d0ughb0y/Chauvet16/chauvet16_schem.pdf

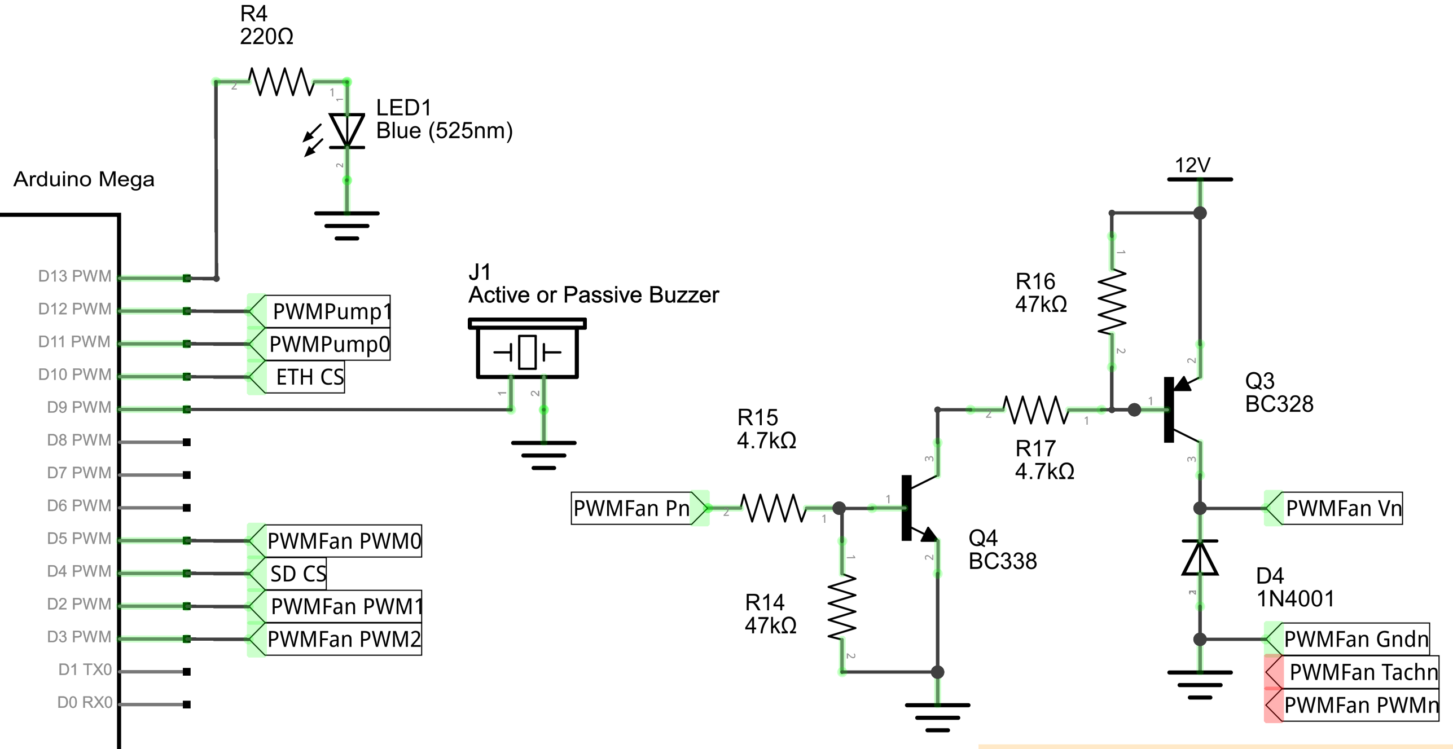
[picture p1: figure]
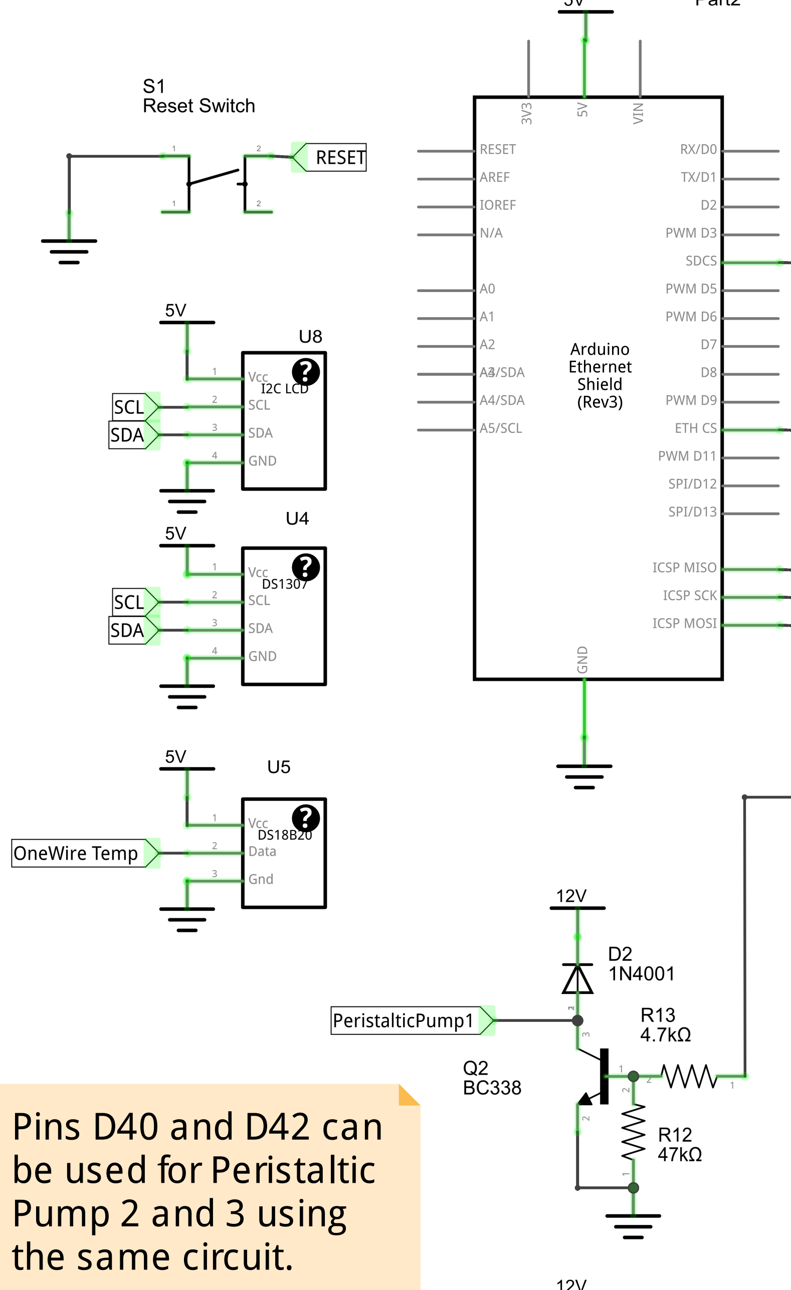
[picture p2: figure]
Pins D40 and D42 can be used for Peristaltic Pump 2 and 3 using the same circuit.

Repeat PWM fan power
drivercircuit for each
additional PWM fan.
PWM 4 pin connector:
Pin1 Gnd, Pin2 V (12v),
Pin3 Tach, Pin4 PWM

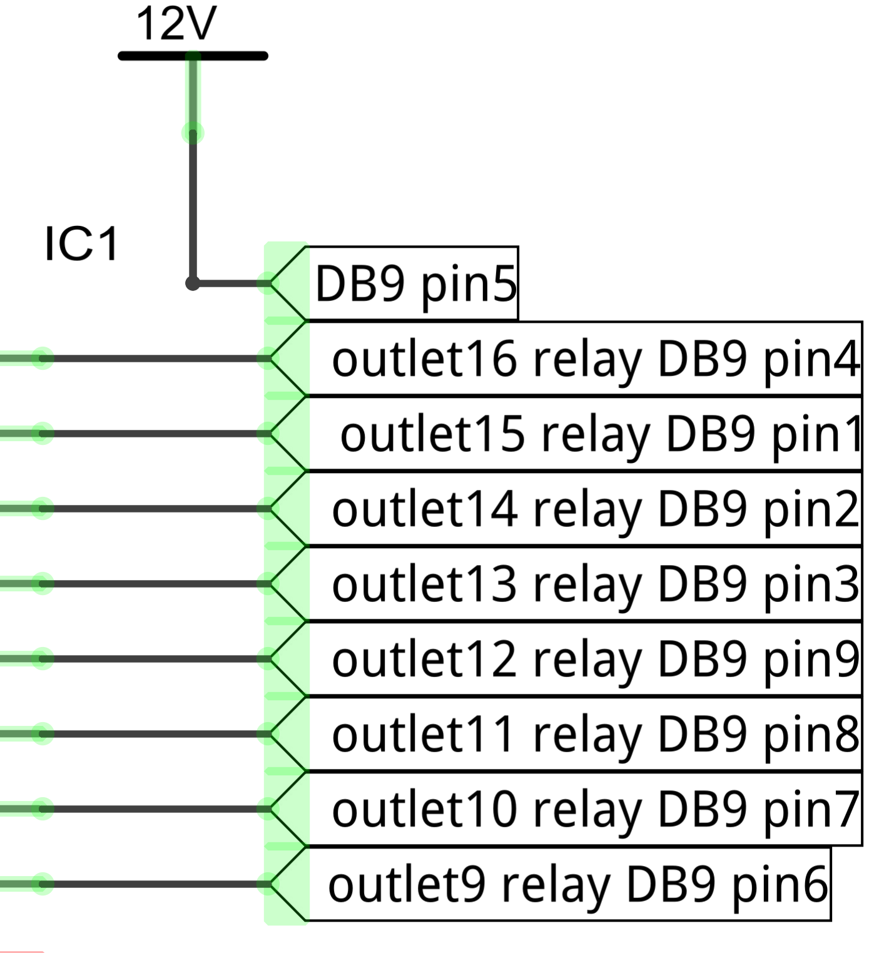
[picture p3: figure]
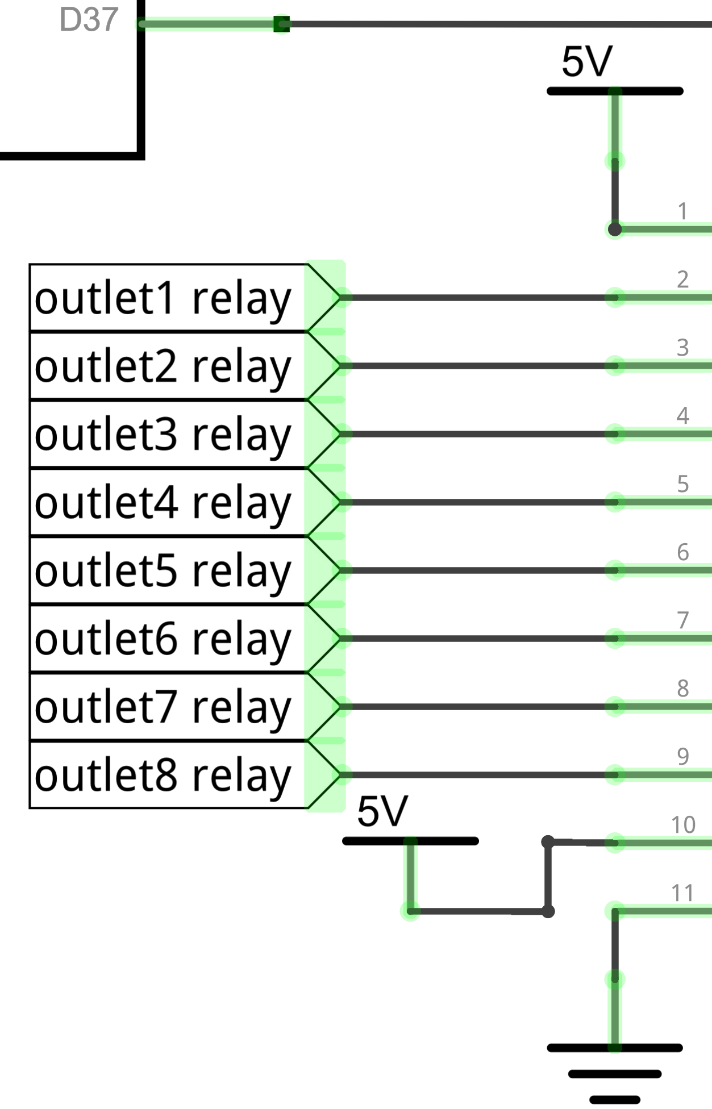
[picture p4: figure]
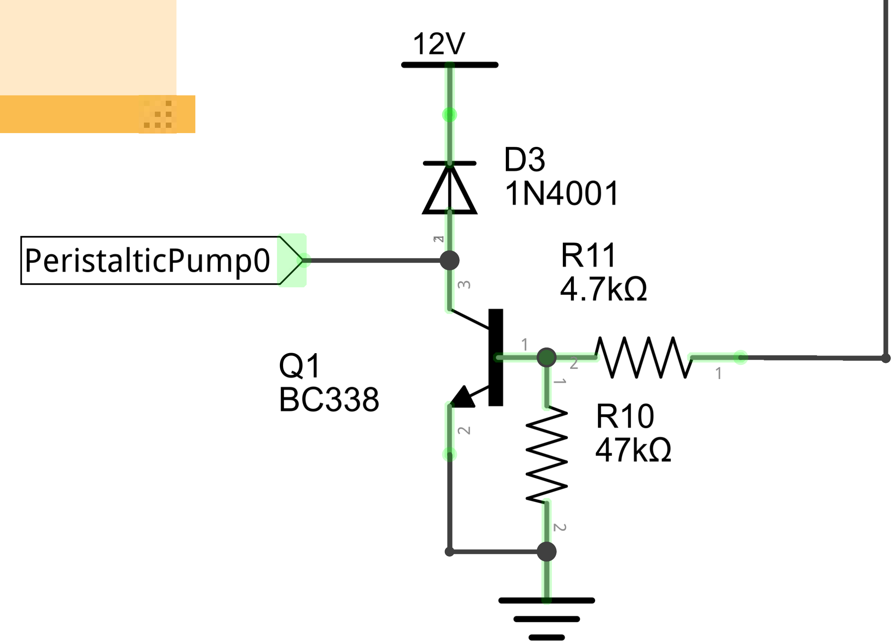
[picture p5: figure]

Use a 12v 1or2a switching powersupply, stepped down to 5v with a buck converterto powerthe Arduino Mega board and the rest of external 5v circuits. Relay board is powered by a separate 5v 1a powersupply. The 12v powersupply is also used to powerthe Doser, PWM fan drivercircuit and second unmodified Chauvet via ULN2803. You can add a powerswitch to the 110v line connected to the 110v inputs of the two powersupplies.

Use a separate 5v supply and Gnd. Disconnect JD-Vcc to Vcc jumper. Install 130vac MOV across each outlet.

Optional additional 8 outlets
