d0ughb0y/Chauvet16/(commit log)

2013-09-17 add schematic file.
2013-09-19 updated schematic to include ethernet shield.
2013-09-21 update readme on arduino libraries setup. update the schematic pdf file
2013-09-22 changed to call netCheck once an hours (at 21 past the hour) instead of at every outlet change. A netCheck call will test if the network is still active and if not will reset the network connection. 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
    [Chauvet16.ino, Outlets.ino, Utils.ino]
2013-10-25 Found conflict between buzzer timer interrupt and pwm pins 2 and 3. Make buzzer use timer4 instead.
    [InterruptsIO.ino]
2013-12-19 Major update to support Jebao WP Pumps
2014-03-09 fix time calculation bug. change unsigned 16 int to a signed integer. use map function to interpolate level value.
    [PWMPumps.ino]
2014-03-09 check sonar level before turning on Kalk (or ATO) pump.
2014-03-09 set all pumps to auto if master pump is set to auto. set all pumps to feed mode if master is set to feed mode.
2014-03-16 make ATO pump manually overridable.
2014-03-22 increase ultrasonic sensor water level measurement resolutioin to 1mm note: all sonar distance fields in config page are in cm unit, the real time reading next to sonar alarm value is in mm.
2014-04-29 add support for inverse cycle for outlets. e.g. refugium light that turns on at night and off during the day. fixed bug in feeder control. fixed misc bugs in index.htm
    [InterruptsIO.ino, Outlets.ino, config.h]
2014-05-10 fix sending email to multiple recipients, and to gmail.
    [Network.ino]
2014-06-26 sync RTC with NTP fix
    [Chauvet16.ino, Outlets.ino]
2014-07-03 fix daily ntp sync bug.
    [Network.ino]
2014-07-03 fix ntp sync bug, again.
    [Network.ino]
2014-08-06 change log +dual doser +multiple temp sensor +simpler feeder version 2 +optimized memory usage +optimized webserver code +optimized loop execution
2014-08-07 fix doser alarm condition automatically reset dosed volume to 0 if container volume is changed
    [Apex.ino, Sensors.ino]
2014-08-08 fix calibratiion bug.
2014-08-08 Fixed bug in displaying http error response. Returns error if manually dosing on uncalibrated doser.
    [Apex.ino, TinyWebServer.cpp]
2014-08-14 fix jebao pump setup page. fix network check.
    [Network.ino]
2014-08-15 fix pwm pump auto initialization for 4 pumps
    [PWMPumps.ino]
2014-08-22 fix email alert bug, add #define DNS_IP and SMTP_IP
    [InterruptsIO.ino, Network.ino, Sensors.ino, Utils.ino, config.h]
2014-08-26 fix OneWire readme instructions and time delay in Sensors.ino
    [Sensors.ino]
2014-08-29 fix ph calibration value for ph>0 bug.
2014-09-05 fix misc setup with no sonar
2014-09-16 fix sonar and sensor lcd display bugs
    use dns to lookup ntp ip
    [Chauvet16.ino, InterruptsIO.ino, Network.ino, Utils.ino, config.h]
2014-09-17 fix lcd display for inverted outlets add temp range check back add define for celsius
    [Sensors.ino, Utils.ino, config.h]
2014-10-21 PWM Fan Initial commit.
2014-10-28 support for atlas i2c.
2014-10-31 fix sensor calibration value display
    [Sensor.cpp]
2014-11-01 fix sensor value formatting
2014-11-02 fix sensor initialization bug
    [Chauvet16.ino, Sensor.cpp, Sensors.ino]
2014-11-02 fix email and sound alert setting bug
    [Apex.ino, config.h]
2014-11-02 fixed doser dosed volume initialization bug. add support for passive buzzer. NOTE: THIS CHANGE REQUIRES MOVING BUZZER CONNECTION TO D9
    [Apex.ino, Chauvet16.ino, InterruptsIO.ino, Utils.ino, config.h]
2014-11-03 update schematic
2014-11-04 fix atlas serial sensor reading bug. increase sonar reading update frequency.
    [Chauvet16.ino, InterruptsIO.ino, Sensor.cpp, config.h]
2014-11-10 add cond and ph temp compensation add cal one to cond calibration
2014-11-16 remove ph temp compensation fix atlas sensor bugs.
    [Apex.ino, Chauvet16.ino, Network.ino, Sensor.cpp, Sensor.h, Sensors.ino, Utils.ino, config.h]
2014-11-20 fix email alert. gmx changed their ip address, going back to using host name.
    [Network.ino, config.h]
2014-11-20 fix bug in inverted outlets.
    [Outlets.ino, Utils.ino, config.h]
2014-11-20 update inverted outlet fix.
    [Utils.ino]
2015-03-09 fix dst bug for Nov 1 as well.
    [Network.ino]
2015-03-09 fix dst bug, previous one has typo.
    [Network.ino]
2015-08-28 Updated source and libraries to compile with Arduino 1.6.5. Unzip libraries.zip into the "libraries" folder in your sketchbook folder.
2016-07-09 fix dst bug fix filenames to be all upper case for compatibility with latest sdfat library which is now case sensitive.
    [Network.ino, Utils.ino]
